raghunandhan27/CrowdShield/docs/images/dfplayer_mini_pinout.jpg

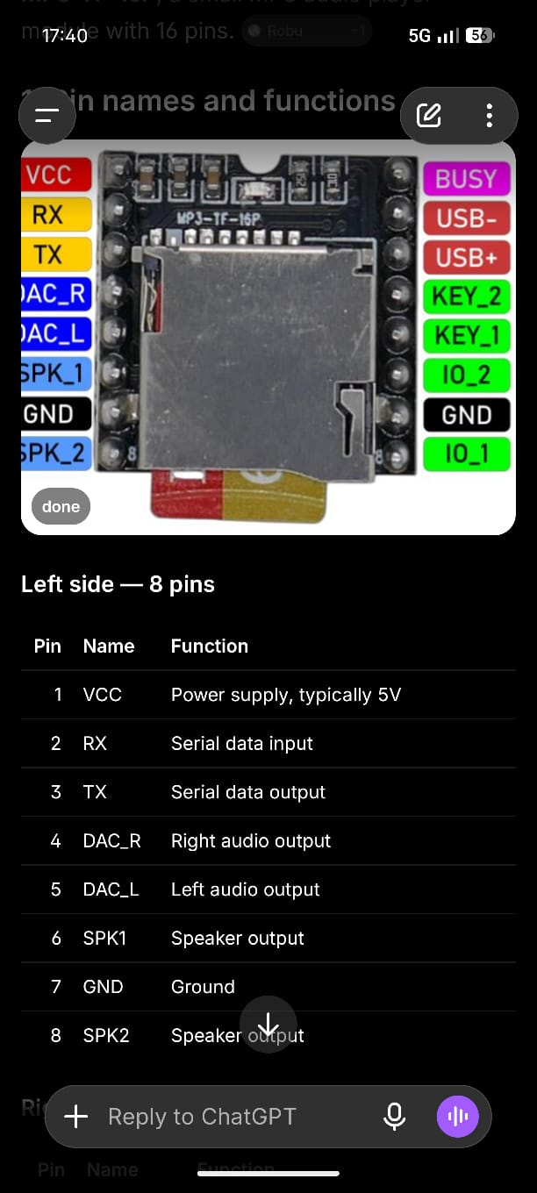
docs/images/dfplayer_mini_pinout.jpg
