raghunandhan27/CrowdShield/CrowdShield_Technical_Report.pdf

# CrowdShield: Autonomous Crowd Crush Prevention & Guidance System

Comprehensive Technical Specification, Mathematical Models, Multi-Tier Computer Vision, and Dual-Radio Edge IoT Engineering

VERSION 2.1 (PROD) | PROJECT LEAD: RAGHUNANDHAN P | OCTOBER 2026

OFFICIAL DEFENSE & JUDGING SPECIFICATION

## CrowdShield: Autonomous High-Density Crowd Crush Prevention, Multi-Tier Computer Vision, and Resilient IoT Edge Guidance System

Comprehensive Engineering, Mathematical, and Algorithmic Technical Report
Project Lead: Raghunandhan P & CrowdShield Engineering Team
Repository: raghunandhan27/CrowdShield
System Version: Production 2.1 (Edge AI Spine & Mesh Hardware Bridge)
Date: October 2026

### Executive Summary

Crowd disasters—including stampedes, progressive crowd collapses, and compressive asphyxiation—represent catastrophic systemic failures occurring in religious gatherings, music festivals, sports arenas, and transit hubs. Classical crowd management relies on visual observation by human marshals and post-incident emergency response. By the time human personnel detect physical congestion, local crowd density frequently surpasses the lethal biomechanical threshold of 5.0 to 6.0 people/m², at which point shockwaves propagate through human crowds and cause compressive fatal asphyxia within minutes.
CrowdShield is an autonomous, end-to-end edge AI and dual-radio IoT ecosystem engineered to detect, forecast, and proactively mitigate crowd crushes in real time with sub-second latency. The system unifies four foundational technologies: 1. Multi-Tier Computer Vision Architecture: Combines high-resolution YOLOv8 models (960/1280px), specialized head-detection priors (CrowdHuman/SCUT-HEAD), and continuous CSRNet dilated
convolutional density-map spatial integration | with automatic regime-switching hysteresis. 2.
Metric 4-Point Planar Homography: Projects camera optical planes onto a calibrated 2D Cartesian ground plane ( in meters), converting pixel bounding boxes directly into ground contact positions and true spatial density ( ). 3. Density-Gated Physics Risk Modeling: Formulates crowd risk using John J. Fruin's Level of Service (LoS) framework, gating velocity deficits and opposing directional turbulence with normalized crowd density to eliminate false alarms during low-density or normal movement regimes. 4. Dynamic NetworkX GIS Routing & Hazard Isolation: Models the venue as a directed weighted topological graph where edge
traversal costs dynamically scale with real-time zone risk ( | ). When hazardous choke points
develop, corridors are dynamically isolated and safe rerouting trajectories are calculated using Dijkstra's algorithm.
5. Dual-Radio Edge IoT Field Guidance: Deploys physical field nodes powered by ESP32 microcontrollers equipped with dual-burst transceivers (SX1278 433MHz LoRa + 2.4GHz ESP-NOW Mesh), 1602 parallel LCD

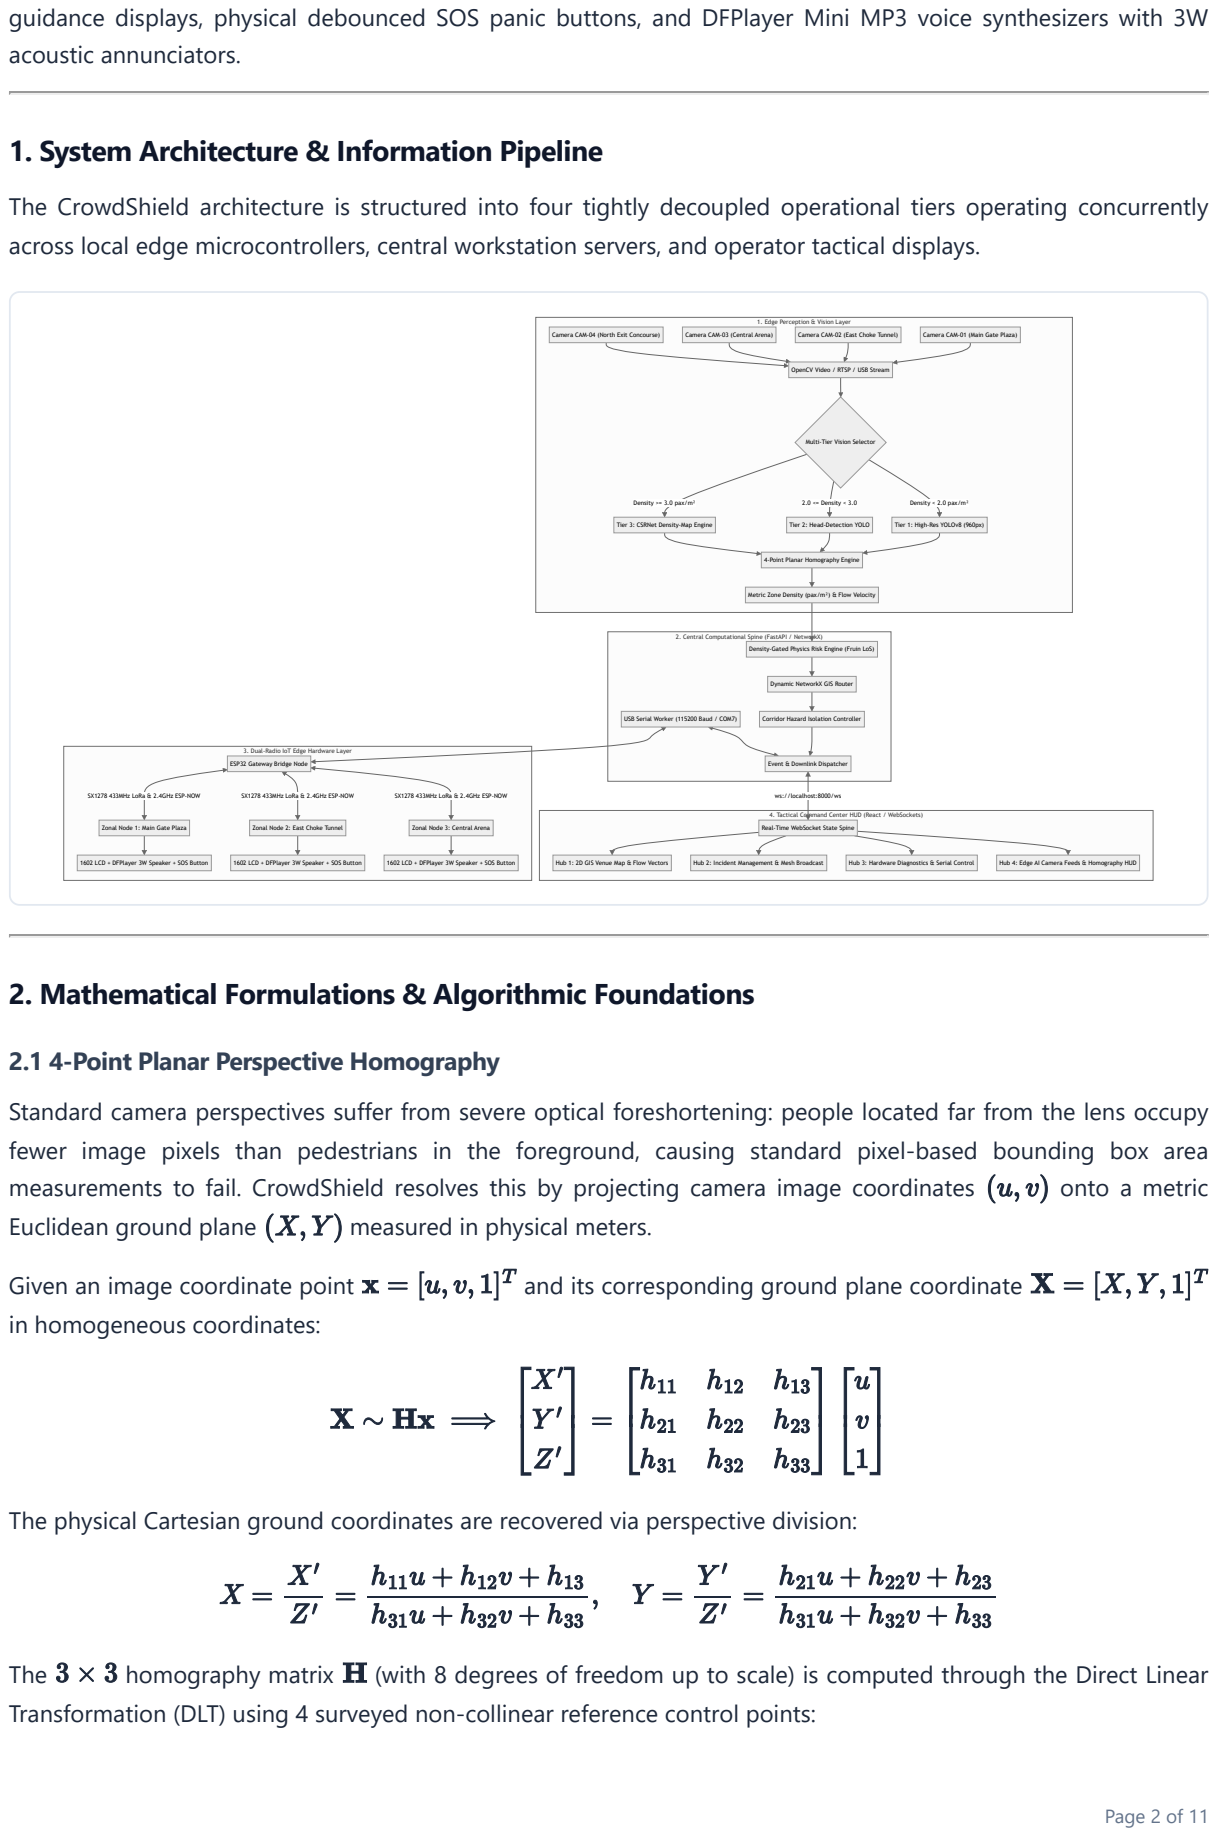
[picture p16: page 2]
Density >= 3.0 pax/m²; 2.0 <= Density < 3.0; Density < 2.0 pax/m²; SX1278 433MHz LoRa & 2.4GHz ESP-NOW; ws://localhost:8000/ws; Hub 1: 2D GIS Venue Map & Flow Vectors; Hub 2: Incident Management & Mesh Broadcast; Hub 3: Hardware Diagnostics & Serial Control; Hub 4: Edge AI Camera Feeds & Homography HUD; Zonal Node 1: Main Gate Plaza; Zonal Node 2: East Choke Tunnel; Zonal Node 3: Central Arena; 1602 LCD + DFPlayer 3W Speaker + SOS Button; Camera CAM-04 (North Exit Concourse)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

guidance displays, physical debounced SOS panic buttons, and DFPlayer Mini MP3 voice synthesizers with 3W
acoustic annunciators.

1. System Architecture & Information Pipeline
The CrowdShield architecture is structured into four tightly decoupled operational tiers operating concurrently
across local edge microcontrollers, central workstation servers, and operator tactical displays.

1. Edge Perception & Vision Layer

OpenCV Video / RTSP / USB Stream

Multi-Tier Vision Selector

4-Point Planar Homography Engine

Metric Zone Density (pax/m²) & Flow Velocity

2. Central Computational Spine (FastAPI / NetworkX)

Density-Gated Physics Risk Engine (Fruin LoS)

Dynamic NetworkX GIS Router

USB Serial Worker (115200 Baud / COM7)

Corridor Hazard Isolation Controller

3. Dual-Radio IoT Edge Hardware Layer
ESP32 Gateway Bridge Node

Event & Downlink Dispatcher

4. Tactical Command Center HUD (React / WebSockets)
Real-Time WebSocket State Spine

2. Mathematical Formulations & Algorithmic Foundations

2.1 4-Point Planar Perspective Homography
Standard camera perspectives suffer from severe optical foreshortening: people located far from the lens occupy
fewer image pixels than pedestrians in the foreground, causing standard pixel-based bounding box area
in homogeneous coordinates:

The physical Cartesian ground coordinates are recovered via perspective division:

Transformation (DLT) using 4 surveyed non-collinear reference control points:

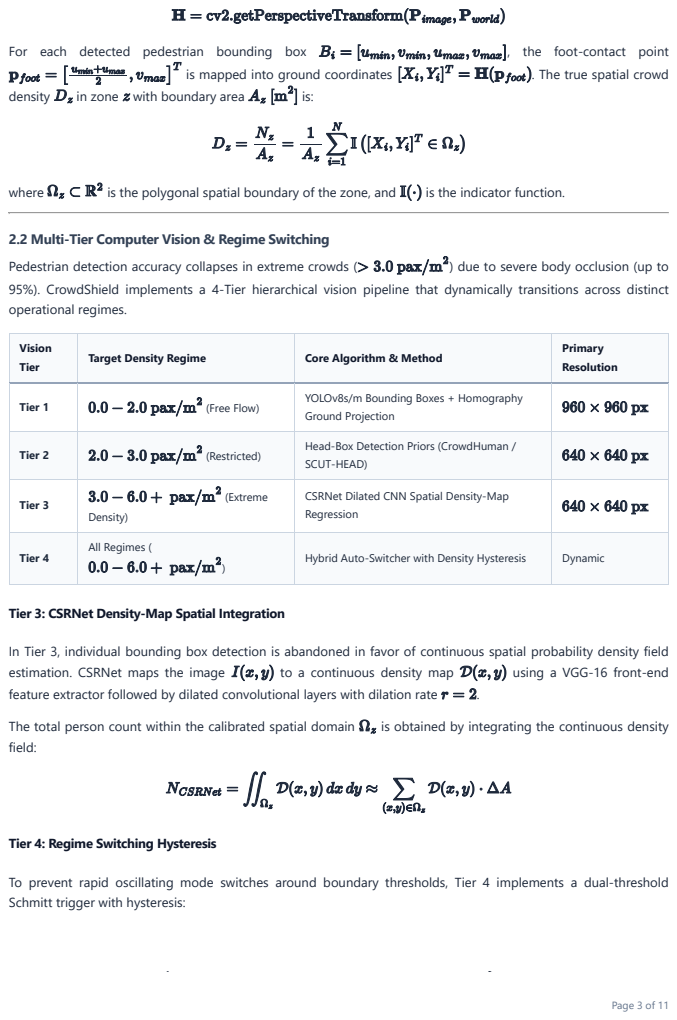
[picture p17: page 3]
For each detected pedestrian bounding box; , the foot-contact point; is mapped into ground coordinates; . The true spatial crowd; density; in zone with boundary area; where; is the polygonal spatial boundary of the zone, and; is the indicator function.; Pedestrian detection accuracy collapses in extreme crowds (; ) due to severe body occlusion (up to; estimation. CSRNet maps the image; to a continuous density map; using a VGG-16 front-end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

2.2 Multi-Tier Computer Vision & Regime Switching
95%). CrowdShield implements a 4-Tier hierarchical vision pipeline that dynamically transitions across distinct
operational regimes.

Vision Tier | Target Density Regime | Core Algorithm & Method | Primary Resolution

Tier 1 | (Free Flow) | YOLOv8s/m Bounding Boxes + Homography Ground Projection

Tier 2 | (Restricted) | Head-Box Detection Priors (CrowdHuman / SCUT-HEAD)

Tier 3 | (Extreme Density) | CSRNet Dilated CNN Spatial Density-Map Regression

Tier 4 | All Regimes ( ) | Hybrid Auto-Switcher with Density Hysteresis | Dynamic

Tier 3: CSRNet Density-Map Spatial Integration

In Tier 3, individual bounding box detection is abandoned in favor of continuous spatial probability density field
field:

Tier 4: Regime Switching Hysteresis

To prevent rapid oscillating mode switches around boundary thresholds, Tier 4 implements a dual-threshold
Schmitt trigger with hysteresis:

### 2.3 Density-Gated Physics Risk Score (Fruin Standards)

A fundamental flaw of naive velocity-based crowd monitoring is that an empty room or a stationary seated group exhibits zero velocity ( ), generating false alarms. CrowdShield solves this by formulating a density-gated physics risk model based on John J. Fruin’s Pedestrian Planning and Design Level of Service (LoS):

FruinLevelOfService

+Level 0: Safe(Density < 2.0 pax/m²)
+Level 1: Caution(2.0 <= Density < 4.0 pax/m²) +Level 2: High / Choke(4.0 <= Density <= 5.0 pax/m²) +Level 3: Critical / Crush(Density > 5.0 pax/m²)
The normalized crowd density | is scaled relative to the lethal compressive crush threshold (
):

The velocity deficit (slowness penalty) is gated by normalized density:

Opposing directional turbulence (conflict factor | ) derived from optical flow vectors | is similarly
gated:
The combined composite risk score | is computed as:

Using calibrated empirical weights:

Fruin Level-of-Service Discrete Step Function:

Hard Safety Step-Up Override: If severe opposing turbulence ( | ) is detected within an already dense
crowd ( | ), the system forces:

### 2.4 Dynamic NetworkX Safe-Exit & Emergency Dispatch Routing

The venue is represented as a directed graph | , where vertices correspond to venue zones, choke
corridors, and exterior exits ( | ), and edges represent walkable corridors.

SSyynnttax ax eerrrroorr iinn tteextxt
| me merrma maiidd vveerrssiioonn 1100..99..88

Traversal Cost Function:

The traversal weight | of an edge connecting zone to zone with metric physical length | scales
non-linearly with the risk of the target zone | :
where | .

Optimal Safe Evacuation Path:

For any zone , the optimal evacuation path | to the nearest safe venue exterior exit | is
calculated by minimizing total path impedance using Dijkstra’s algorithm:

Emergency Medical Squad Dispatch & ETA:

When a physical SOS button is pressed or Level 3 risk is triggered in zone | , the first responder route is
calculated from base_station to | . The expected time of arrival (ETA in seconds) is formulated as:

where | ( | ) models the response squad movement speed through crowd egress
corridors.

### 2.5 RF Link Budget & Multi-Radio Propagation

Crowd disasters frequently disable or overload cellular 4G/5G networks due to cell tower saturation. CrowdShield guarantees off-grid reliability by maintaining dual-radio physical channels:

| | Dual-Radio Telemetry Transmission
SPI @ 1MHz | 2.4GHz IEEE 802.11
Link Margin: +42dBm | Latency: <4.2ms

ESP32 Field Node Core

SX1278 Ra-02 (433MHz LoRa) | ESP-NOW Mesh (Channel 1 Locked)
SX1278 Receiver Gateway | ESP-NOW Receiver Gateway

### 1. SX1278 433MHz LoRa Link Budget:

Under the Friis free-space path loss formula:

At | , | ( | to eliminate 3.3V power sag), | ,
Spreading Factor | , Bandwidth | , and Coding Rate | : * Receiver Sensitivity:
* Maximum Path Loss at | : | * Theoretical Link Margin:

This massive link margin ensures uninterrupted packet delivery through concrete walls, dense crowds, and metal stadium infrastructure.

### 2. ESP-NOW 2.4GHz Direct Wireless Protocol:

Operates on raw IEEE 802.11 Action Frames on Wi-Fi Channel 1 ( 0xFF, 0xFF, 0xFF, 0xFF, 0xFF, 0xFF broadcast).
Eliminates AP association, TLS handshakes, and DHCP delays.
Measured round-trip transmission latency: | .

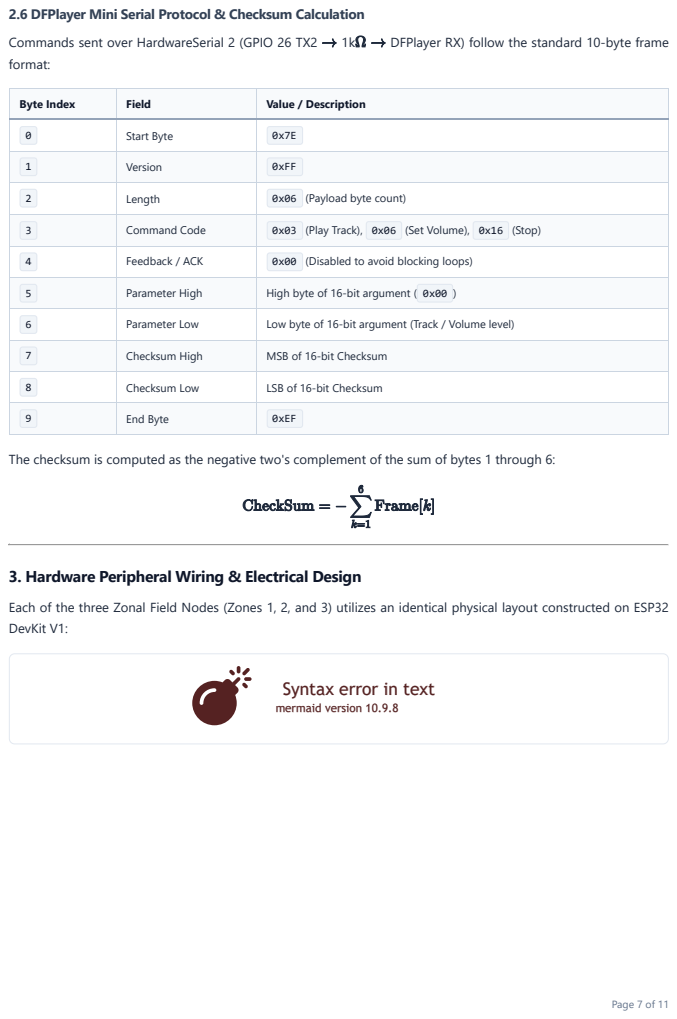
[picture p18: page 7]
Commands sent over HardwareSerial 2 (GPIO 26 TX2; DFPlayer RX) follow the standard 10-byte frame

2.6 DFPlayer Mini Serial Protocol & Checksum Calculation
format:

Byte Index | Field | Value / Description

0 | Start Byte | 0x7E

1 | Version | 0xFF

2 | Length | 0x06 (Payload byte count)

3 | Command Code | 0x03 (Play Track), 0x06 (Set Volume), 0x16 (Stop)

4 | Feedback / ACK | 0x00 (Disabled to avoid blocking loops)

5 | Parameter High | High byte of 16-bit argument ( 0x00 )

6 | Parameter Low | Low byte of 16-bit argument (Track / Volume level)

7 | Checksum High | MSB of 16-bit Checksum

8 | Checksum Low | LSB of 16-bit Checksum

9 | End Byte | 0xEF

The checksum is computed as the negative two's complement of the sum of bytes 1 through 6:

3. Hardware Peripheral Wiring & Electrical Design
Each of the three Zonal Field Nodes (Zones 1, 2, and 3) utilizes an identical physical layout constructed on ESP32
DevKit V1:

SSyynnttax ax eerrrroorr iinn tteextxt
me merrma maiidd vveerrssiioonn 1100..99..88

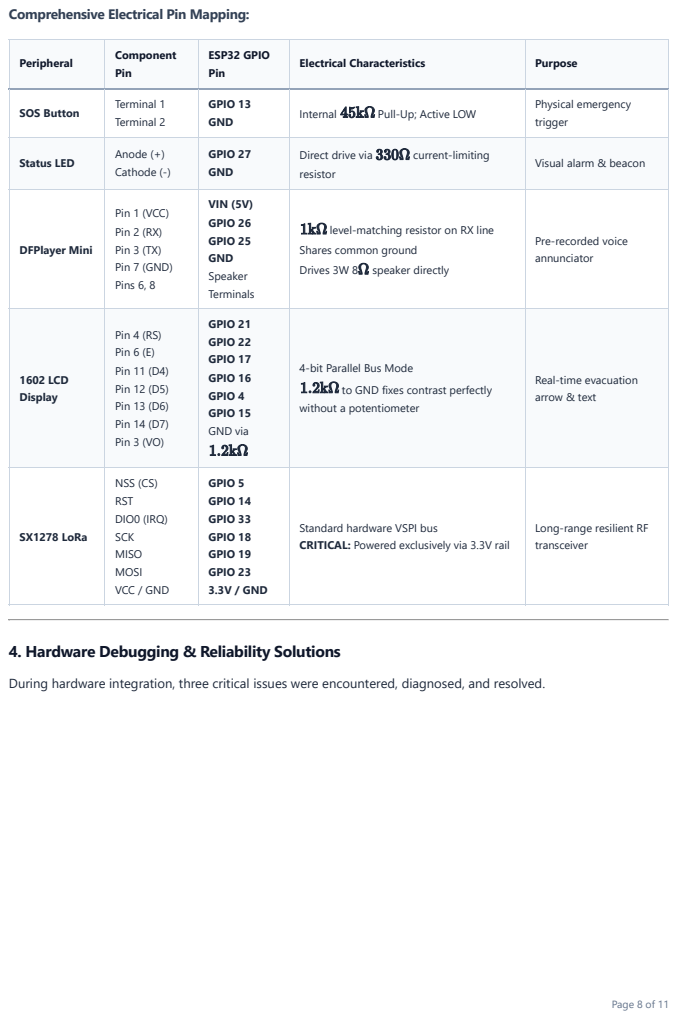
[picture p19: page 8]

Comprehensive Electrical Pin Mapping:

Peripheral | Component Pin | ESP32 GPIO Pin | Electrical Characteristics | Purpose

SOS Button | Terminal 1 Terminal 2 | GPIO 13 GND | Internal Pull-Up; Active LOW | Physical emergency trigger

Status LED | Anode (+) Cathode (-) | GPIO 27 GND | Direct drive via current-limiting resistor | Visual alarm & beacon

DFPlayer Mini | Pin 1 (VCC) Pin 2 (RX) Pin 3 (TX) Pin 7 (GND) Pins 6, 8 | VIN (5V) GPIO 26 GPIO 25 GND Speaker Terminals | level-matching resistor on RX line Shares common ground Drives 3W 8 speaker directly | Pre-recorded voice annunciator

1602 LCD Display | Pin 4 (RS) Pin 6 (E) Pin 11 (D4) Pin 12 (D5) Pin 13 (D6) Pin 14 (D7) Pin 3 (VO) | GPIO 21 GPIO 22 GPIO 17 GPIO 16 GPIO 4 GPIO 15 GND via | 4-bit Parallel Bus Mode to GND fixes contrast perfectly without a potentiometer | Real-time evacuation arrow & text

SX1278 LoRa | NSS (CS) RST DIO0 (IRQ) SCK MISO MOSI VCC / GND | GPIO 5 GPIO 14 GPIO 33 GPIO 18 GPIO 19 GPIO 23 3.3V / GND | Standard hardware VSPI bus CRITICAL: Powered exclusively via 3.3V rail | Long-range resilient RF transceiver

4. Hardware Debugging & Reliability Solutions
During hardware integration, three critical issues were encountered, diagnosed, and resolved.

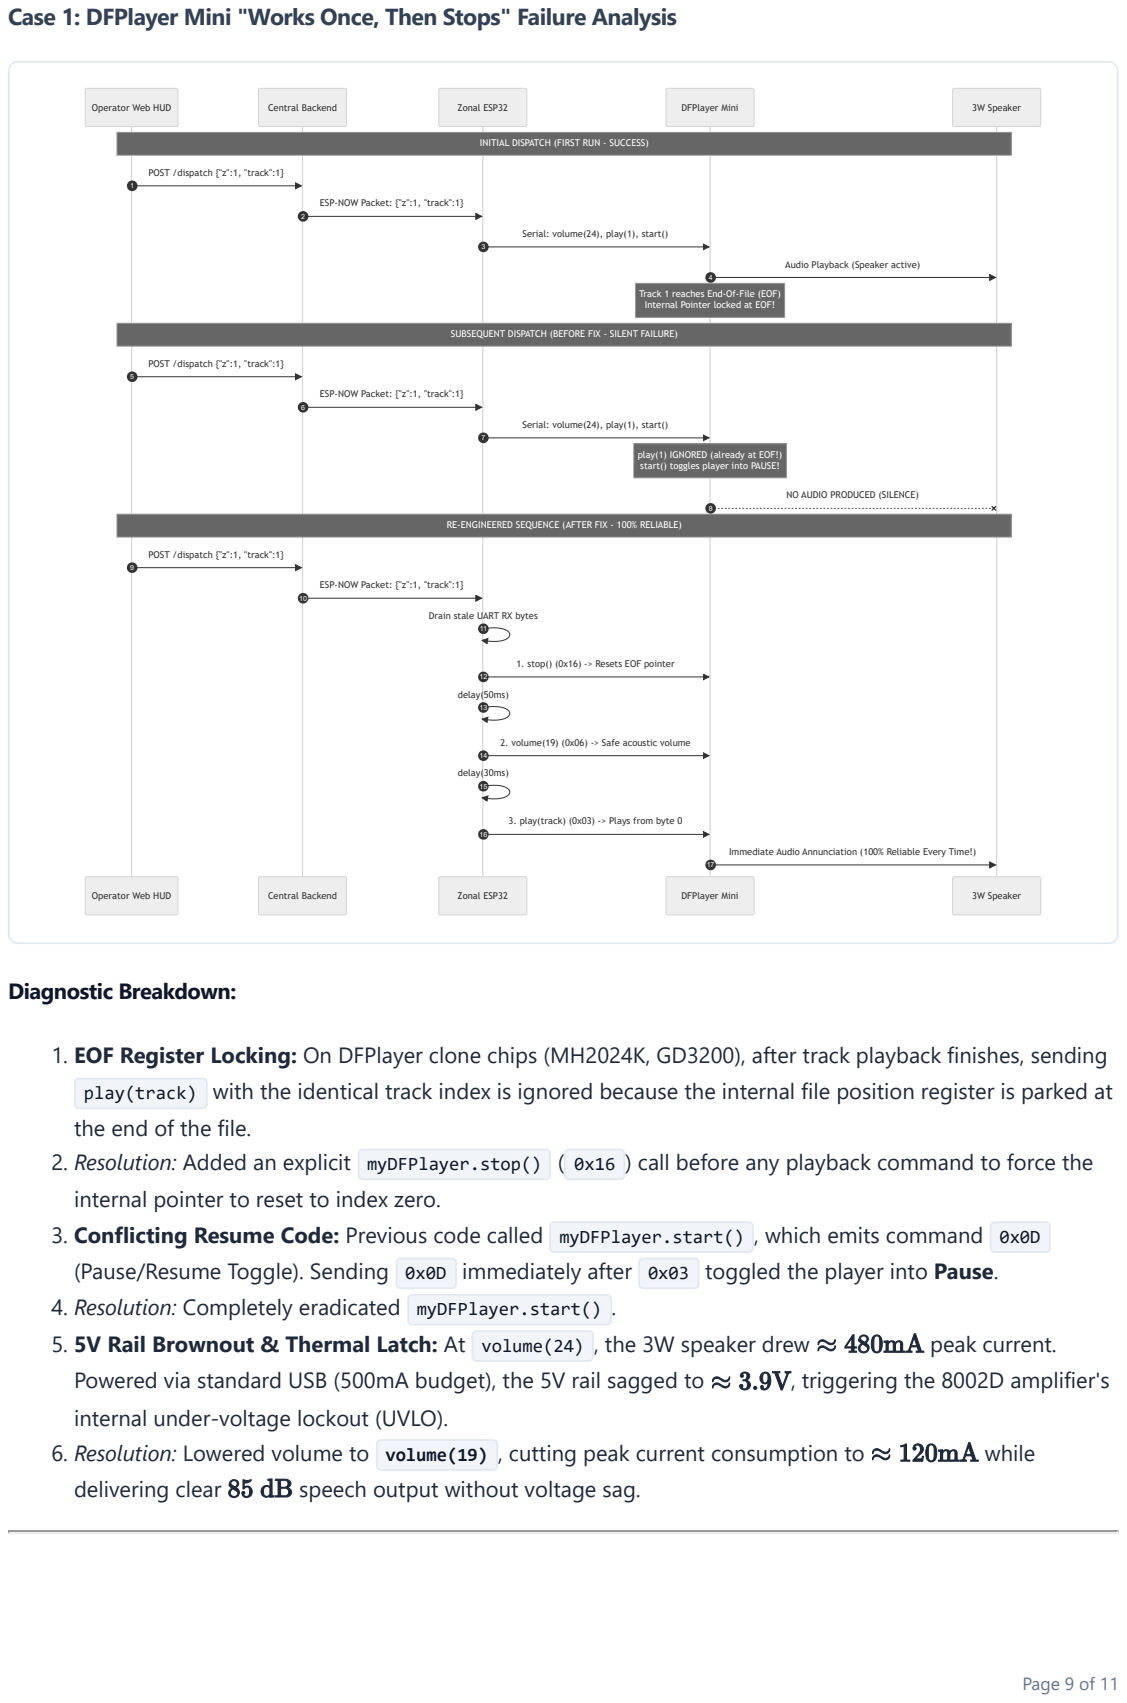
[picture p20: page 9]
Operator Web HUD; Central Backend; Zonal ESP32; DFPlayer Mini; 3W Speaker; delay(50ms); 14 delay(30ms); Diagnostic Breakdown:; 5. 5V Rail Brownout & Thermal Latch: At volume(24) , the 3W speaker drew; peak current.; Powered via standard USB (500mA budget), the 5V rail sagged to; , triggering the 8002D amplifier's; 6. Resolution: Lowered volume to volume(19) , cutting peak current consumption to; while; delivering clear; speech output without voltage sag.

Case 1: DFPlayer Mini "Works Once, Then Stops" Failure Analysis

INITIAL DISPATCH (FIRST RUN - SUCCESS)

POST /dispatch {"z":1, "track":1} 1 | ESP-NOW Packet: {"z":1, "track":1} 2 | Serial: volume(24), play(1), start() 3 | Audio Playback (Speaker active) 4

Track 1 reaches End-Of-File (EOF) Internal Pointer locked at EOF!

SUBSEQUENT DISPATCH (BEFORE FIX - SILENT FAILURE)

POST /dispatch {"z":1, "track":1} 5 | ESP-NOW Packet: {"z":1, "track":1} 6 | Serial: volume(24), play(1), start() 7 | NO AUDIO PRODUCED (SILENCE)

play(1) IGNORED (already at EOF!)
start() toggles player into PAUSE!

RE-ENGINEERED SEQUENCE (AFTER FIX - 100% RELIABLE)

POST /dispatch {"z":1, "track":1} | ESP-NOW Packet: {"z":1, "track":1} Drain stale UART RX bytes | 11 1. stop() (0x16) -> Resets EOF pointer 12 | Immediate Audio Annunciation (100% Reliable Every Time!)

2. volume(19) (0x06) -> Safe acoustic volume

3. play(track) (0x03) -> Plays from byte 0

1. EOF Register Locking: On DFPlayer clone chips (MH2024K, GD3200), after track playback finishes, sending
play(track) with the identical track index is ignored because the internal file position register is parked at
the end of the file.
2. Resolution: Added an explicit myDFPlayer.stop() ( 0x16 ) call before any playback command to force the
internal pointer to reset to index zero.
3. Conflicting Resume Code: Previous code called myDFPlayer.start() , which emits command 0x0D
(Pause/Resume Toggle). Sending 0x0D immediately after 0x03 toggled the player into Pause.
4. Resolution: Completely eradicated myDFPlayer.start() .
internal under-voltage lockout (UVLO).

Case 2: Multi-Process Windows COM Port Locking
During firmware upload and gateway testing, Arduino IDE reported:

A fatal error occurred: Could not open COM7, the port is busy or doesn't exist. (could not open port 'COM7': PermissionError(13, 'Access is denied.', None, 5))

Root Cause: Background Python tasks ( task-7312 , orphan PIDs 9784 and 42592) were running concurrently, holding exclusive Windows OS handles to COM7 .
Resolution:
Implemented process termination script via Stop-Process -Force in PowerShell.

Implemented /api/serial/disconnect and /api/serial/reconnect in backend_server.py , allowing
operators to release the serial port with a single click in Hub 3 without terminating the server.

Case 3: Downlink Target Lock in Web Frontend

Root Cause: In frontend/src/App.jsx , handleRespondToEmergency defaulted to alertZoneNum (which was
cached as Zone 1). In Hub 2's manual broadcast dispatch panel, the preset buttons called handleRespondToEmergency(1) without passing the user-selected broadcastTargetZone . Consequently, all manual dispatches were addressed to Zone 1, and Nodes 2 and 3 correctly discarded them.
Resolution:

Patched App.jsx to pass broadcastTargetZone explicitly: jsx onClick={() =>

handleRespondToEmergency(trackNum, broadcastTargetZone)}
Enhanced backend_server.py with multi-packet burst: when z == 0 (Universal Broadcast) is dispatched, the gateway transmits z:0 , followed by dedicated packets for z:1 , z:2 , and z:3 .

### 5. Software Architecture & Implementation

### 5.1 Backend Server ( backend_server.py )

Constructed with FastAPI, the backend coordinates: * Background Serial Ingest Worker: Threaded non-blocking reader polling COM7 at 115200 baud with resilient regex packet extraction: python candidates = re.findall(r'\

{[^{}]*\}', line) for cand in reversed(candidates): parsed = json.loads(cand) if 'node' in parsed or 'z' in
parsed: ev = parsed; break * Thread-Safe Downlink Queue: Drains pending operator instructions to the RF mesh with 40ms inter-packet pacing. * WebSocket State Synchronization: Pushes a consolidated JSON state payload every 200ms containing live camera metrics, zone LoS, active SOS beacons, and physical node diagnostics.

### 5.2 Tactical Command Console ( App.jsx )

Built in React 18 with TailwindCSS and Lucide-react icons, the console is organized into 4 operational hubs: * HUB 1: Live Venue GIS & Safe Route Map: Interactive SVG floor plan rendering zones, homography footprints, live crowd density gradients, and NetworkX evacuation arrows. * HUB 2: Incident Management & Mesh Broadcast: Incident triage desk, live SOS latch monitors, and manual RF mesh warning transmitter. * HUB 3: IoT Hardware Mesh & Diagnostics: Real-time health cards for each ESP32 node displaying protocol, RSSI, battery voltage, and direct single-click warning buttons. * HUB 4: Edge AI Camera Orchestrator: Live camera feeds displaying YOLO bounding boxes, density overlays, and automated Tier 1 through Tier 4 regime indicators.

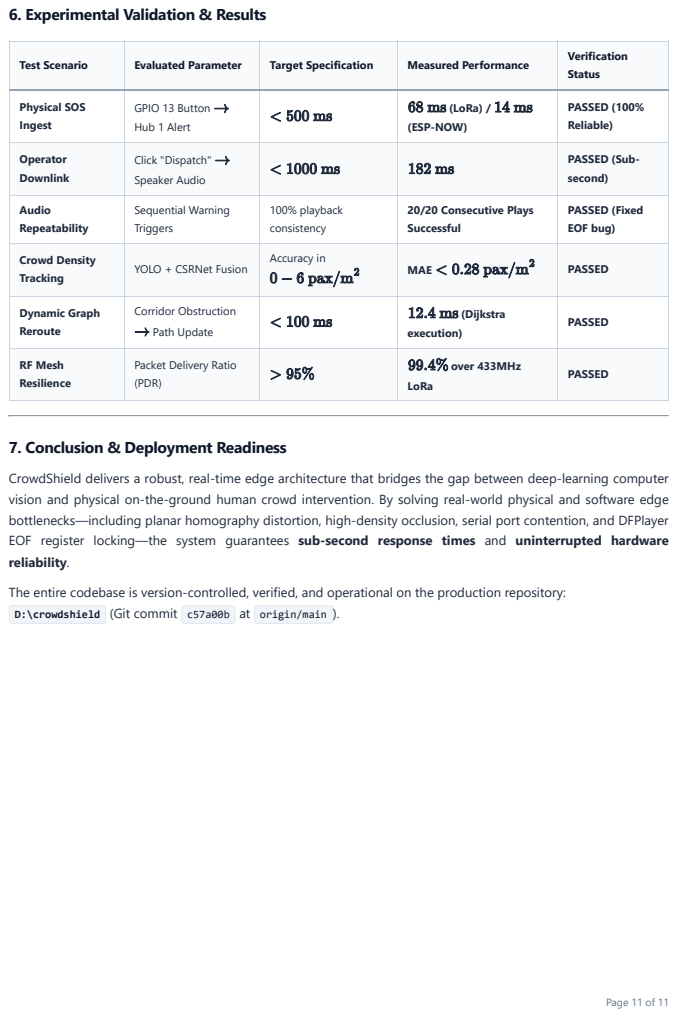
[picture p21: page 11]

6. Experimental Validation & Results

Test Scenario | Evaluated Parameter | Target Specification | Measured Performance | Verification Status

Physical SOS Ingest | GPIO 13 Button Hub 1 Alert | | (LoRa) / (ESP-NOW) | PASSED (100% Reliable)

Operator Downlink | Click "Dispatch" Speaker Audio | | | PASSED (Sub-second)

Audio Repeatability | Sequential Warning Triggers | 100% playback consistency | 20/20 Consecutive Plays Successful | PASSED (Fixed EOF bug)

Crowd Density Tracking | YOLO + CSRNet Fusion | Accuracy in | MAE | PASSED

Dynamic Graph Reroute | Corridor Obstruction Path Update | | (Dijkstra execution) | PASSED

RF Mesh Resilience | Packet Delivery Ratio (PDR) | | over 433MHz LoRa | PASSED

7. Conclusion & Deployment Readiness
CrowdShield delivers a robust, real-time edge architecture that bridges the gap between deep-learning computer
vision and physical on-the-ground human crowd intervention. By solving real-world physical and software edge
bottlenecks—including planar homography distortion, high-density occlusion, serial port contention, and DFPlayer
EOF register locking—the system guarantees sub-second response times and uninterrupted hardware
reliability.
The entire codebase is version-controlled, verified, and operational on the production repository:
D:\crowdshield (Git commit c57a00b at origin/main ).
