raghunandhan27/CrowdShield/(commit log)

2026-10-27 feat(demo): add interactive 3-zone multi-density sample scenario demonstrating YOLO, CSRNet, Farneback and GIS rerouting
2026-10-27 feat(fire): add ground-staff and camera-feed incident intake with dynamic safest route navigation
2026-10-27 feat(demo): 3-zone synthetic camera feeds with low, medium, and very high risk levels linked to GIS mapping and dense-crowd AI
2026-10-28 refactor(hardware): remap SOS switch from GPIO 12 to GPIO 13 with debounce across all zonal firmware
2026-10-28 fix(audio): non-blocking DFPlayer initialization and debounce across all zonal sketches
    [zonal_esp32.ino, zonal_esp32_zone2.ino, zonal_esp32_zone3.ino]
2026-10-28 fix(firmware): eliminate 1602 LCD flickering via text caching and standardize GPIO 13 button debounce across all zonal nodes
    [test_all_hardware.ino, test_lora_transmitter.ino, zonal_esp32.ino, zonal_esp32_espnow.ino, zonal_esp32_zone1.ino, zonal_esp32_zone2.ino, zonal_esp32_zone3.ino]
2026-10-29 fix(vision): auto-switch to CSRNet on dense crowd occlusion collapse and fix density calculation
    [vision_engine.py]
2026-10-29 refactor(hud): replace pulsing circle animations with professional enterprise bounding boxes
    [backend_server.py]
2026-10-29 feat(cleanup): remove dummy offline node placeholders and link metrics to live cameras
2026-10-29 fix(serial): terminate stale processes, connect COM7 directly, and add robust bracketed JSON packet parser
    [backend_server.py]
2026-10-29 fix(audio): enable DFPlayer speaker playback by setting SILENT_PRESENTATION_MODE to 0 across all zonal nodes
    [test_all_hardware.ino, zonal_esp32.ino, zonal_esp32_zone1.ino, zonal_esp32_zone2.ino, zonal_esp32_zone3.ino]
2026-10-29 Fix Zonal Node 2 and Node 3 DFPlayer handshake, downlink zone targeting, and universal RF broadcast
    [backend_server.py, zonal_esp32_zone1.ino, zonal_esp32_zone2.ino, zonal_esp32_zone3.ino]
2026-10-29 Fix DFPlayer re-play EOF lockup, safe volume 19 power stabilization, and serial port contention
    [backend_server.py, zonal_esp32_zone1.ino, zonal_esp32_zone2.ino, zonal_esp32_zone3.ino]
